xcd0/rp/readme.md

# RP2040を直接実装した自作キーボードを作成する

いきなりは難しいので最初にRaspberry Pi Pico相当のものを作成して、動作確認し、  
そのうえで作成する。  
完成は春節前を目標とする。  

* [調査1](./1.md)
* [調査2](./2.md)
* [試作1](./rp2040_slim_v1/rp2040_slim_v1.md)
* [試作2](./rp2040_slim_v2/rp2040_slim_v2.md)
