xcd0/rp/rp2040_slim_v2/rp2040_slim_v2.md

# 試作2

* raspberry pi pico相当の基板を作成する。  
* 試作1を改善する。

## 試作1の改善余地

* もう少し幅を詰める。

## ざっくり仕様

* USB-C
* できるだけ幅を狭くする
	* 長くてもよい
	* 不要なGPIOは基板をカットして捨ててもよい
* できるだけ片面実装

## 試作した基板

* サイズ 13.12mm x 50mm
	* raspberry pi pico は 21mm x 51mm
	* 試作1は 15mm x 59mm
	* 面積比でみると公式の61.2%
	* 幅
		* だいぶいい感じになった。この幅なら満足。
		* これ以上はUSB-Cコネクタを厳選する必要がある。
	* 長さ
		* 不要なGPIOの分基板をカットできるかに関しては、5mmカットできる状態。
			* 公式は14mmくらいカットできる。カットできる部分をカットすると、18mm x 37mmくらいになる。
			* 試作のコンセプトは幅を狭くなので、長さで張り合うつもりはない。公式のは部品サイズも小さい。
* これ以上は
	* 部品を小さくする
	* 両面実装にする
	* 無くても動く部品を削る
	* 大きな部品を変更する

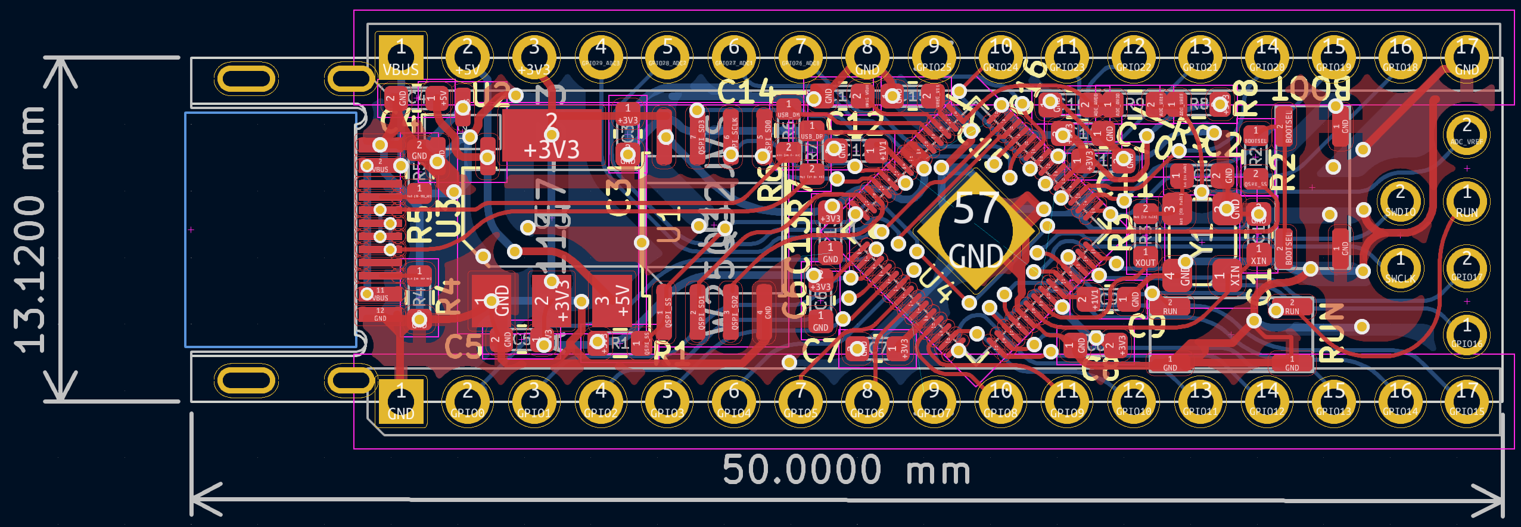
[picture p10: rp2040_slim_v2/pcb.png]


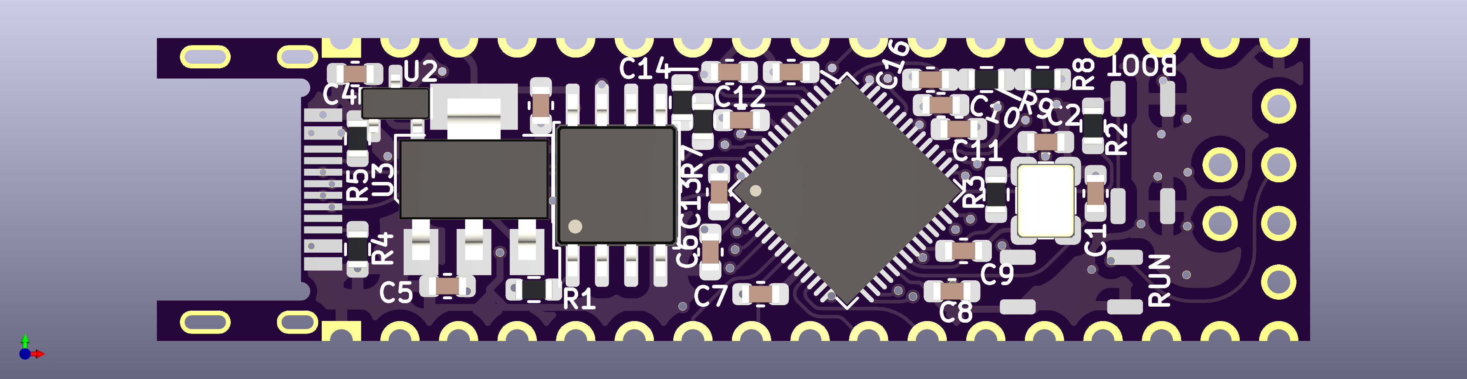
[picture p11: rp2040_slim_v2/3dview.png]
