xcd0/rp/2.md

# 調査2 rp2040のデータシート

https://github.com/xcd0/rp2040_datasheet

にpdfから変換したmarkdownを置いた。

pdfだと和約しにくい。  
markdownだとそのままgoogle翻訳にかけられるので見やすい。
