xcd0/rp/rp2040_slim_v1/slim_20240116_no_vcut.pdf

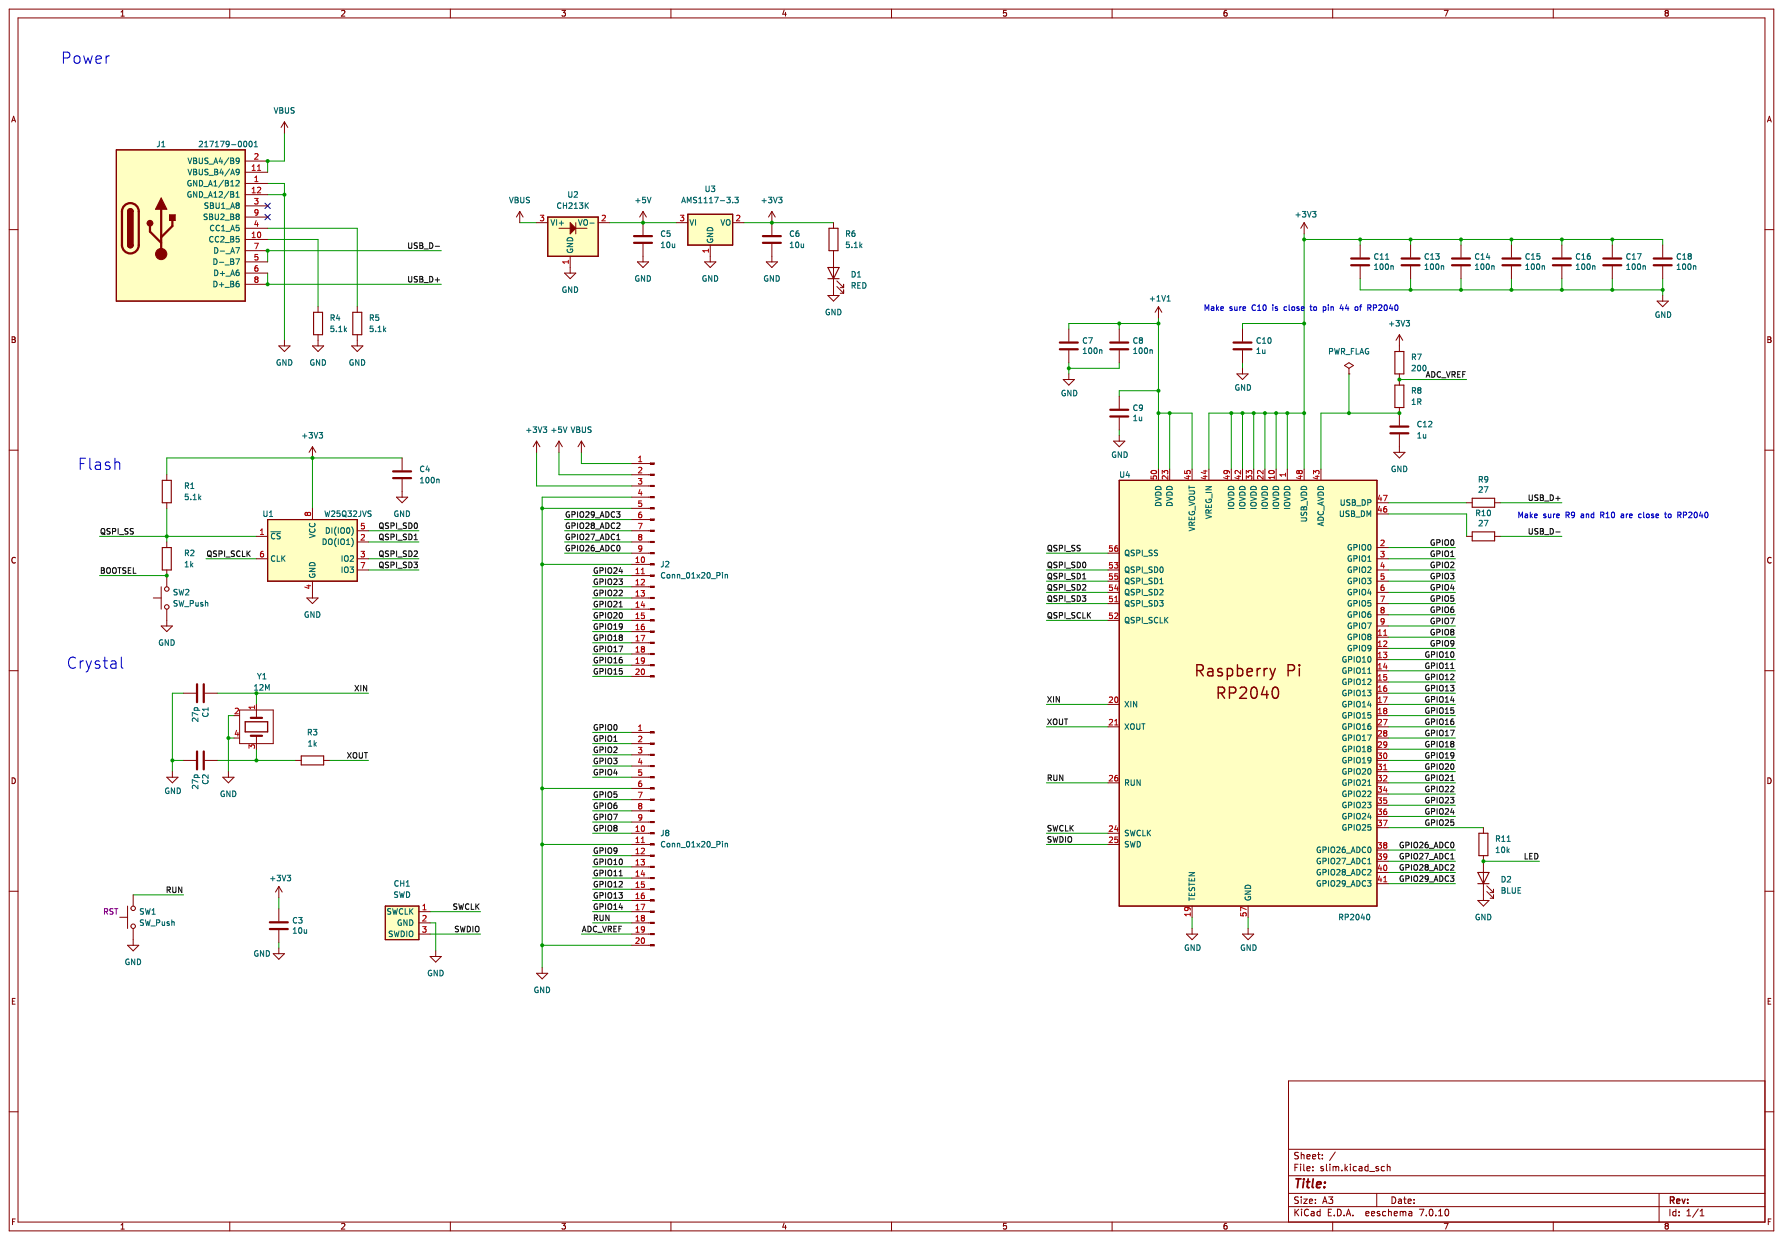
[picture p12: page 1]
