xcd0/rp/slim.kicad_pcb

## KiCad design slim.kicad_pcb (2024-01-20)

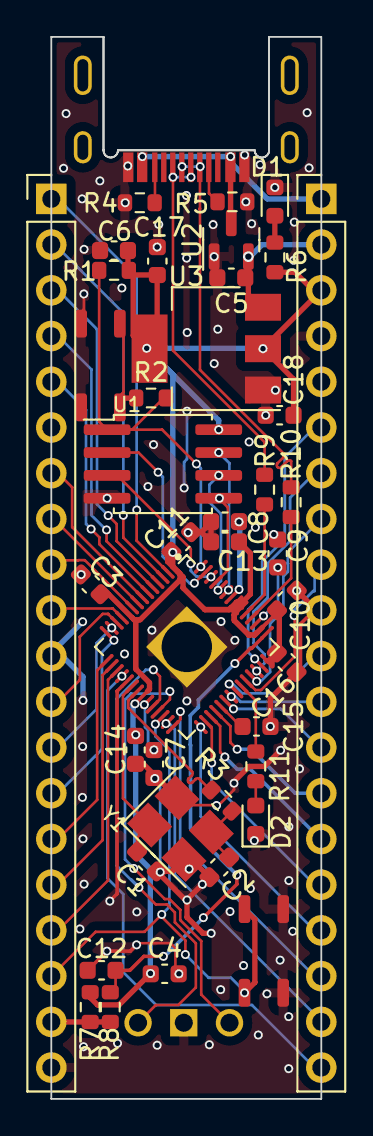
[picture p13: board slim.kicad_pcb from above]

Board: 2 copper layers, 15.0 x 59.0 mm, 42 parts (0 on the bottom side), 58 nets.

Parts:
BOOT: SW_Push; SKRPABE010
C1, C2: 27p; C_0603_1608Metric
C3, C5, C6: 10u; C_0603_1608Metric
C4, C7, C8, C11, C13, C14, C15, C16, C17, C18: 100n; C_0603_1608Metric
C9, C10, C12: 1u; C_0603_1608Metric
CH1: SWD; SWD_PIN
D1: RED; LED_0603_1608Metric
D2: BLUE; LED_0603_1608Metric
J1: 217179-0001; USB-C-12-Pin-MidMount-ali-v2
J2, J8: Conn_01x20_Pin; PinHeader_1x20_P2.54mm_Vertical
R1, R4, R5, R6: 5.1k; R_0603_1608Metric
R2, R3: 1k; R_0603_1608Metric
R7: 200; R_0603_1608Metric
R8: 1R; R_0603_1608Metric
R9, R10: 27; R_0603_1608Metric
R11: 10k; R_0603_1608Metric
RUN: SW_Push; SKRPABE010
U1: W25Q32JVS; W25Q16-128JV-SOIC
U2: CH213K; SOT-23
U3: AMS1117-3.3; Regulator-AMS1117-SOT-223
U4: RP2040; RP2040_hand
Y1: 12M; Crystal_SMD_3225-4Pin_3.2x2.5mm_HandSoldering

Connections:
+1V1: C7.1, C8.1, C9.1, U4.23 (DVDD), U4.45 (VREG_VOUT), U4.50 (DVDD)
+3V3: C3.1, C4.1, C6.1, C10.1, C11.1, C13.1, C14.1, C15.1, C16.1, C17.1, C18.1, J2.3, R1.2, R6.2, R7.2, U1.8 (VCC), U3.2 (VO), U4.1 (IOVDD), U4.10 (IOVDD), U4.22 (IOVDD), U4.33 (IOVDD), U4.42 (IOVDD), U4.44 (VREG_IN), U4.48 (USB_VDD), U4.49 (IOVDD)
+5V: C5.1, J2.2, U2.2 (VO-), U3.3 (VI)
/ADC_VREF: J8.19, R7.1, R8.2
/BOOTSEL: BOOT.2, R2.1
/GPIO0: J8.1, U4.2 (GPIO0)
/GPIO1: J8.2, U4.3 (GPIO1)
/GPIO2: J8.3, U4.4 (GPIO2)
/GPIO3: J8.4, U4.5 (GPIO3)
/GPIO4: J8.5, U4.6 (GPIO4)
/GPIO5: J8.7, U4.7 (GPIO5)
/GPIO6: J8.8, U4.8 (GPIO6)
/GPIO7: J8.9, U4.9 (GPIO7)
/GPIO8: J8.10, U4.11 (GPIO8)
/GPIO9: J8.12, U4.12 (GPIO9)
/GPIO10: J8.13, U4.13 (GPIO10)
/GPIO11: J8.14, U4.14 (GPIO11)
/GPIO12: J8.15, U4.15 (GPIO12)
/GPIO13: J8.16, U4.16 (GPIO13)
/GPIO14: J8.17, U4.17 (GPIO14)
/GPIO15: J2.20, U4.18 (GPIO15)
/GPIO16: J2.19, U4.27 (GPIO16)
/GPIO17: J2.18, U4.28 (GPIO17)
/GPIO18: J2.17, U4.29 (GPIO18)
/GPIO19: J2.16, U4.30 (GPIO19)
/GPIO20: J2.15, U4.31 (GPIO20)
/GPIO21: J2.14, U4.32 (GPIO21)
/GPIO22: J2.13, U4.34 (GPIO22)
/GPIO23: J2.12, U4.35 (GPIO23)
/GPIO24: J2.11, U4.36 (GPIO24)
/GPIO25: R11.1, U4.37 (GPIO25)
/GPIO26_ADC0: J2.9, U4.38 (GPIO26_ADC0)
/GPIO27_ADC1: J2.8, U4.39 (GPIO27_ADC1)
/GPIO28_ADC2: J2.7, U4.40 (GPIO28_ADC2)
/GPIO29_ADC3: J2.6, U4.41 (GPIO29_ADC3)
/LED: D2.2 (A), R11.2
/QSPI_SCLK: U1.6 (CLK), U4.52 (QSPI_SCLK)
/QSPI_SD0: U1.5 (DI(IO0)), U4.53 (QSPI_SD0)
/QSPI_SD1: U1.2 (DO(IO1)), U4.55 (QSPI_SD1)
/QSPI_SD2: U1.3 (IO2), U4.54 (QSPI_SD2)
/QSPI_SD3: U1.7 (IO3), U4.51 (QSPI_SD3)
/QSPI_SS: R1.1, R2.2, U1.1 (~CS), U4.56 (QSPI_SS)
/RUN: J8.18, RUN.2, U4.26 (RUN)
/SWCLK: CH1.1 (SWCLK), U4.24 (SWCLK)
/SWDIO: CH1.3 (SWDIO), U4.25 (SWD)
/USB_D+: J1.6 (D+_A6), J1.8 (D+_B6), R9.1
/USB_D-: J1.5 (D-_B7), J1.7 (D-_A7), R10.1
/XIN: C1.1, U4.20 (XIN), Y1.1
/XOUT: R3.1, U4.21 (XOUT)
GND: BOOT.1, C1.2, C2.2, C3.2, C4.2, C5.2, C6.2, C7.2, C8.2, C9.2, C10.2, C11.2, C12.2, C13.2, C14.2, C15.2, C16.2, C17.2, C18.2, CH1.2 (GND), D1.1 (K), D2.1 (K), J1.1 (GND_A1/B12), J1.12 (GND_A12/B1), J2.4, J2.5, J2.10, J8.6, J8.11, J8.20, R4.2, R5.2, RUN.1, U1.4 (GND), U2.1 (GND), U3.1 (GND), U4.19 (TESTEN), U4.57 (GND), Y1.2, Y1.4
unnamed: C2.1, R3.2, Y1.3
unnamed: D1.2 (A), R6.1
unnamed: J1.4 (CC1_A5), R5.1
unnamed: J1.10 (CC2_B5), R4.1
unnamed: C12.1, R8.1, U4.43 (ADC_AVDD)
unnamed: R10.2, U4.46 (USB_DM)
unnamed: R9.2, U4.47 (USB_DP)
VBUS: J1.2 (VBUS_A4/B9), J1.11 (VBUS_B4/A9), J2.1, U2.3 (VI+)
